Lab217MX/Cerberus-A-USB-Watchdog/Hardware/README.md

# Hardware

Recursos de hardware del proyecto Cerberus USB Watchdog.

## Contenido

### CerberusZero/

PCB principal del dispositivo Cerberus. Incluye el proyecto editable, archivos Gerber para fabricación y coordenadas para ensamblaje SMT.

- **Más información:** Ver [CerberusZero/README.md](CerberusZero/README.md)

### ADUM3160 USB Isolator/

Módulo aislador USB basado en el chip ADUM3160. Proporciona protección contra ataques USB-Killer mediante aislamiento galvánico.

- **Función:** Aísla eléctricamente el host del dispositivo USB, bloqueando picos de alto voltaje
- **Uso:** Complemento opcional para añadir una capa extra de seguridad física
- **Más información:** Ver [ADUM3160 USB Isolator/README.md](ADUM3160%20USB%20Isolator/README.md)

### Cerberus Display/

Placa de display (OLED + botones) en KiCad. Proyecto editable disponible; los Gerbers y Pick & Place aún **no se liberan** porque la placa está en validación.

- **Más información:** Ver [Cerberus Display/README.md](Cerberus%20Display/README.md)
