Lab217MX/Cerberus-A-USB-Watchdog/SCH_Schematic1_2026-06-15.pdf

# USBKiller Protection

### GPIO1

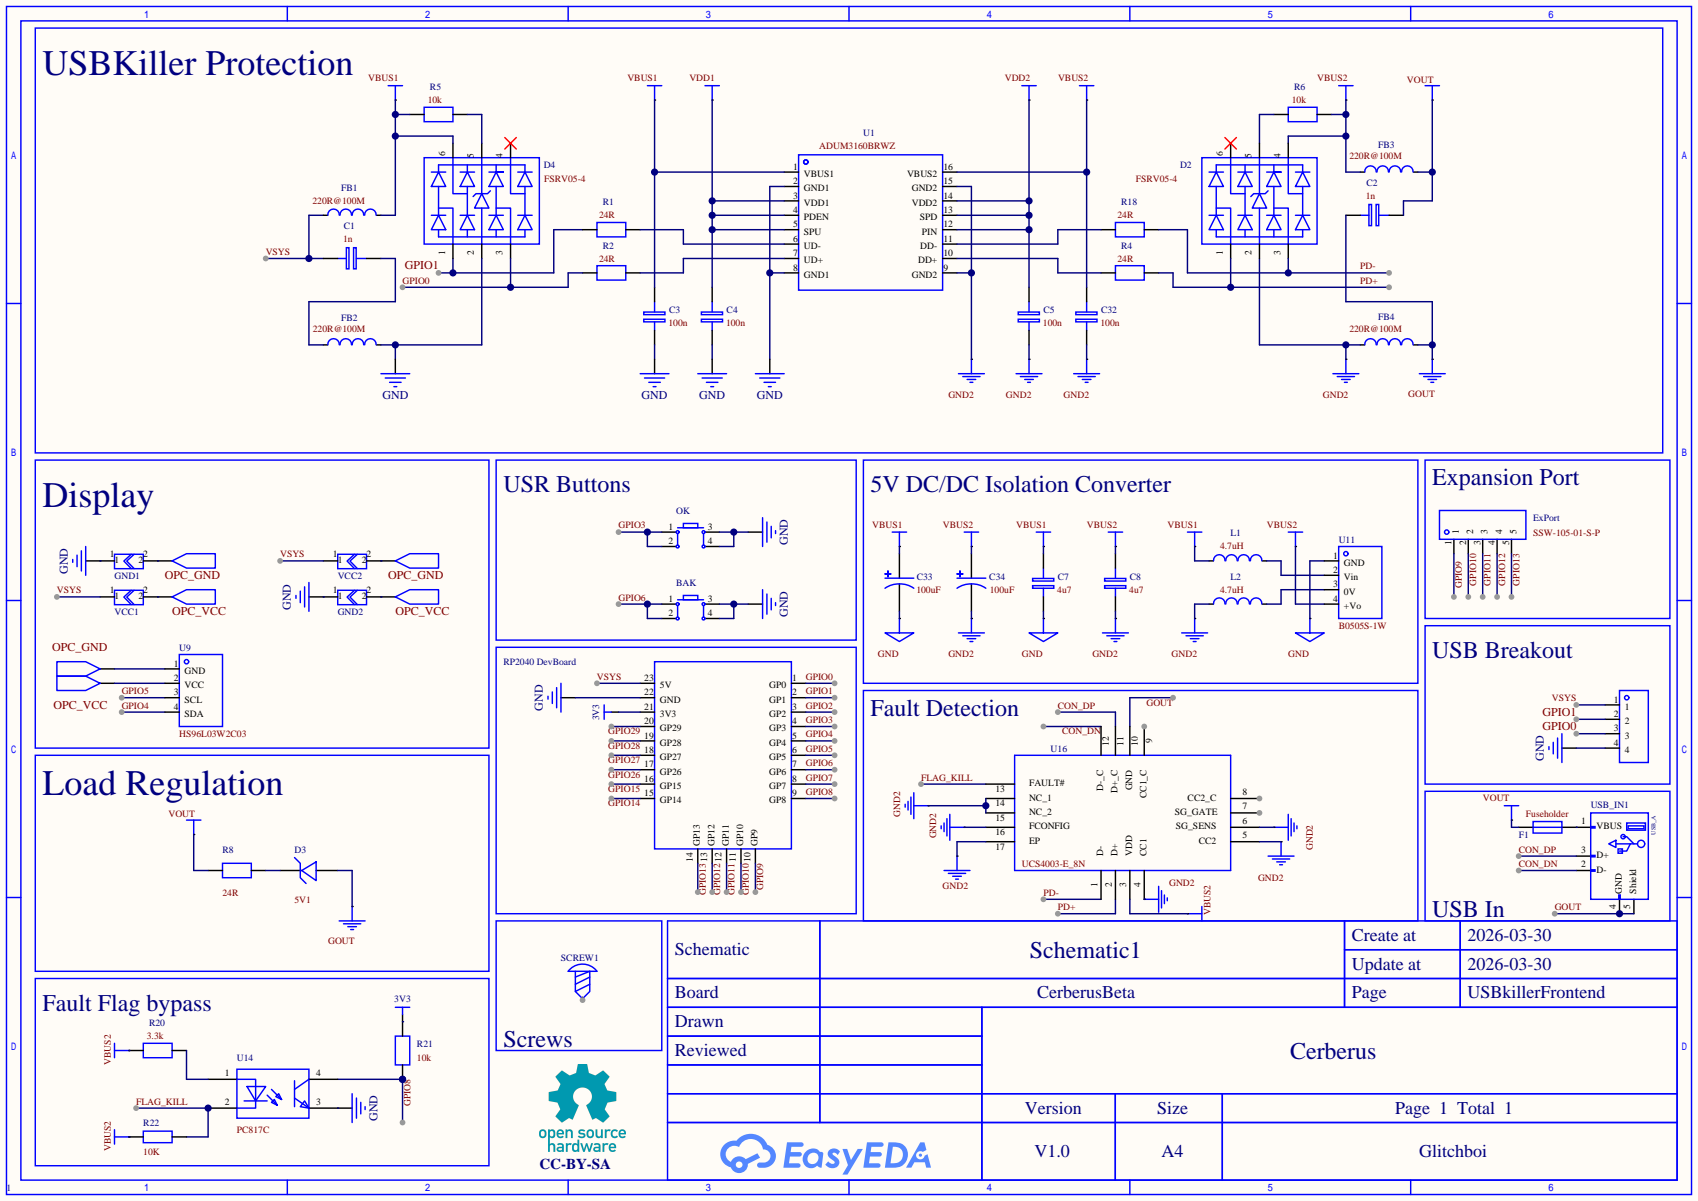
[picture p2: page 1]

5V DC/DC Isolation Converter

Schematic | Schematic1 | Create at | 2026-03-30

Update at | 2026-03-30

Board | CerberusBeta | Page | USBkillerFrontend
Drawn | | Cerberus
Reviewed

Version | Size | Page 1 Total 1

V1.0 | A4 | Glitchboi
