Lab217MX/Cerberus-A-USB-Watchdog/(list of files, drawings)

Other design files:
Hardware/CerberusZero/CerberusZero_V1.epro
