Lab217MX/Cerberus-A-USB-Watchdog/Hardware/Cerberus Display/ProPrj_Cerberus_2026-09-25.kicad_pcb

## KiCad design Hardware/Cerberus Display/ProPrj_Cerberus_2026-09-25.kicad_pcb (2026-10-14)

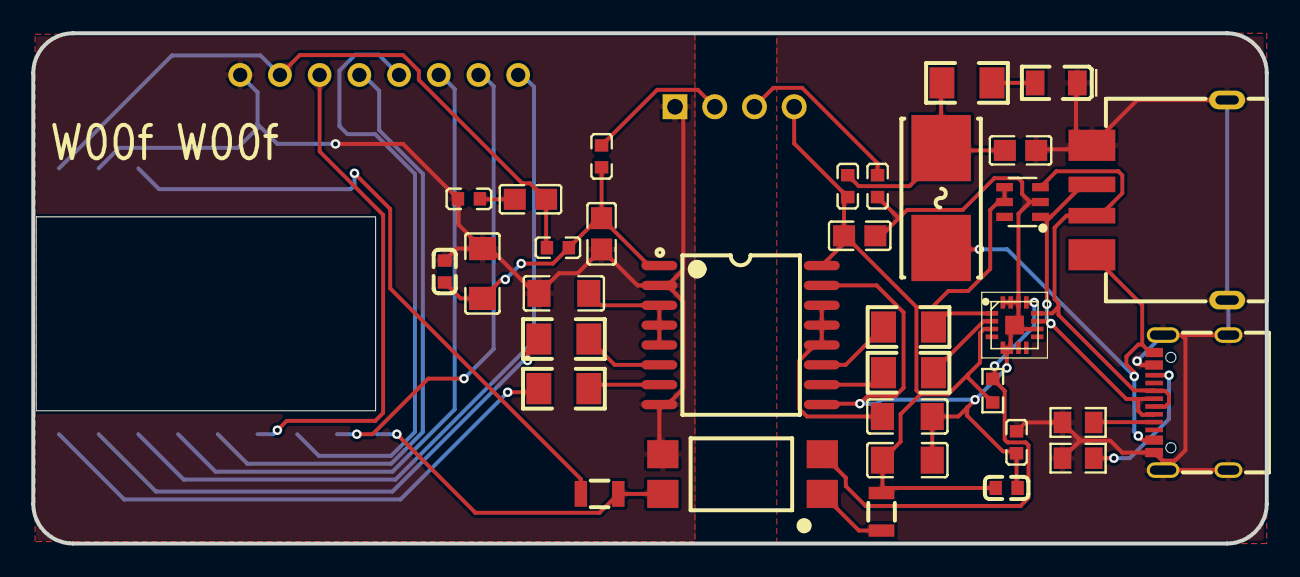
[picture p3: board ProPrj_Cerberus_2026-09-25.kicad_pcb from above]

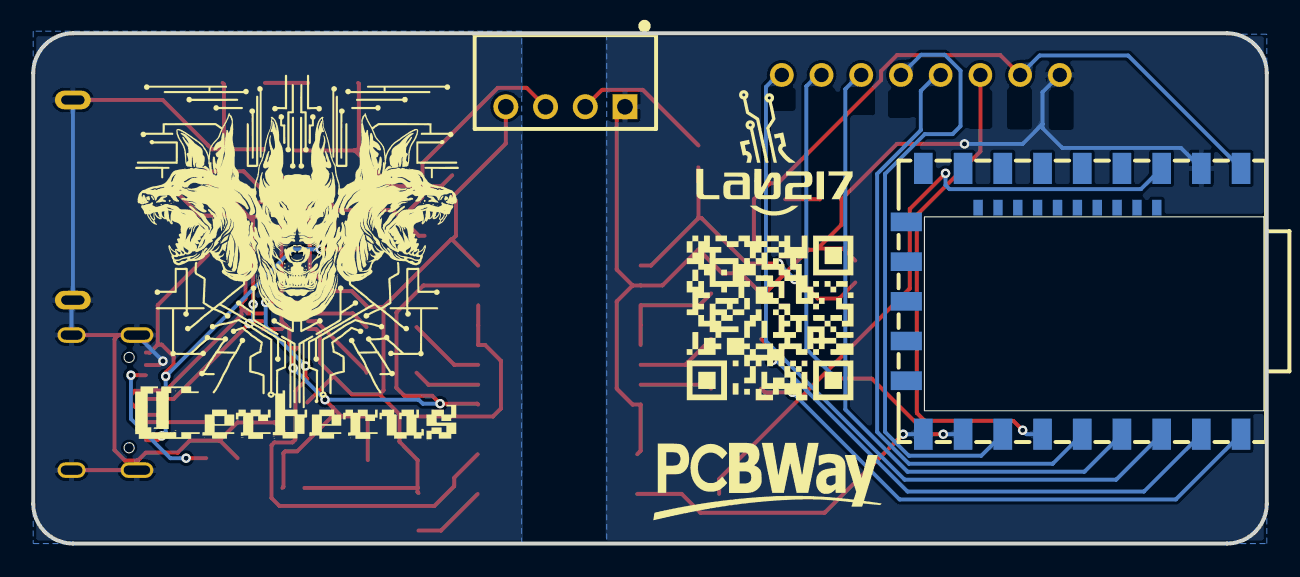
[picture p4: board ProPrj_Cerberus_2026-09-25.kicad_pcb from below]

Board: 2 copper layers, 78.9 x 32.6 mm, 37 parts (2 on the bottom side), 36 nets.

Parts:
C2, C14, C33, C34: C0805
C3, C4, C5, C32: C1206
C7, C8: C0603
D2: SOT-23-6_L2.9-W1.6-P0.95-LS2.8-BL
D3: D1206-RD_S13773
F2: FUSE-SMD_L9.7-W5.0
FB1, FB2, FB3, FB4: L0603
L1, L2: L0603
R1, R2, R4, R8, R18: R1206_1
R3, R5: R0805
R20, R21: RES-SMD_L3.2-W1.6_HCS1206FTL500
R22: R0603
U1: SOIC-16_L10.3-W7.5-P1.27-LS10.3-TL
U2: SOP-4_L6.5-W4.6-P2.54-LS10.2-TL
U4: SSD1306 128X64 4KEYS
U11: PWRM-TH_BXXXXS-1W
U15: COMM-SMD_RP2040-ZERO
U16: QFN50P300X300X100-17N
USB1: TYPE-C-SMD_LAIL-TYPE-C-16PIN-08-WT
USB2: USB-A-SMD_USB-100SD-F2

Connections:
3V3: R21.2, U15.21
$2N7232: D3.2, R8.2
$2N8019: R1.2, U1.6
$2N8020: R2.2, U1.7
$2N8021: R4.1, U1.10
$2N8022: R18.1, U1.11
$2N8501: L1.2, U11.2
$2N8502: L2.2, U11.3
$2N13465: R20.1, U2.1
$2N22688: R18.2, U16.1
$2N22689: R4.2, U16.2
$2N22702: R3.2, USB1.A5
$2N22703: R5.2, USB1.B5
$2N22723: C14.1, FB2.2
CON_DN: D2.1, U16.11, USB1.A7, USB1.B7, USB2.3
CON_DP: D2.3, U16.12, USB1.A6, USB1.B6, USB2.2
FLAG_KILL: R22.1, U2.2, U16.13
GND: C3.1, C4.1, C7.1, C33.2, FB2.1, U1.2, U1.8, U2.3, U4.1, U11.1, U15.22
GND2: C5.1, C8.1, C32.1, C34.2, D2.2, FB4.1, L2.1, U1.9, U1.15, U16.5, U16.6, U16.10, U16.14, U16.15, U16.16, U16.17
GOUT: C2.1, D3.1, FB4.2, R3.1, R5.1, USB1.13, USB1.14, USB1.15, USB1.16, USB1.A1B12, USB1.B4A9, USB2.4, USB2.5, USB2.6
GPIO0: R2.1, U15.1
GPIO1: R1.1, U15.2
GPIO2: U4.8, U15.3
GPIO3: U4.6, U15.4
GPIO4: U4.4, U15.5
GPIO5: U4.3, U15.6
GPIO6: U4.5, U15.7
GPIO7: U4.7, U15.8
GPIO8: R21.1, U2.4, U15.9
VBUS1: C3.2, C7.2, C33.1, FB1.2, L1.1, U1.1
VBUS2: C8.2, C32.2, C34.1, D2.4, D2.5, FB3.1, R20.2, R22.2, U1.16, U11.4, U16.3
VDD1: C4.2, U1.3, U1.4, U1.5
VDD2: C5.2, U1.12, U1.13, U1.14
VOUT: C2.2, F2.1, FB3.2, R8.1
VSYS: C14.2, FB1.1, U4.2, U15.23
V_FUSE: F2.2, USB1.A4B9, USB1.B1A12, USB2.1
