Lab217MX/Cerberus-A-USB-Watchdog/Software/Cerberus/resources.h

#pragma once

#include <stddef.h>
#include <stdint.h>

// Footer icons (small)
static const unsigned char PROGMEM image_arrow_curved_left_up_bits[] = {0xf0,0xe0,0xf1,0xbe,0x18};
static const unsigned char PROGMEM image_Lock_bits[] = {0x38,0x44,0x44,0xfe,0xfe,0xee,0xfe,0x7c};
static const unsigned char PROGMEM image_Quest_bits[] = {0x78,0xcc,0xcc,0x0c,0x18,0x30,0x00,0x30};

// Main logos - USB cable connected (16x16 = 32 bytes)
static const unsigned char PROGMEM image_usb_cable_connected_bits[] = {
  0x00,0x00,0x00,0x00,0x00,0x00,0x00,0xc0,
  0x03,0xe0,0x04,0xc0,0x08,0x04,0xc8,0x06,
  0xff,0xff,0xc2,0x06,0x02,0x04,0x01,0x30,
  0x00,0xf8,0x00,0x30,0x00,0x00,0x00,0x00
};

// Alert triangle (16x16 = 32 bytes)
static const unsigned char PROGMEM image_Alert_bits[] = {
  0x00,0x00,0x01,0x80,0x02,0x40,0x02,0x40,
  0x04,0x20,0x09,0x90,0x09,0x90,0x11,0x88,
  0x11,0x88,0x21,0x84,0x40,0x02,0x41,0x82,
  0x81,0x81,0x80,0x01,0x7f,0xfe,0x00,0x00
};

// Evil smile / skull (24x21 = 63 bytes)
static const unsigned char PROGMEM image_EviSmile1_bits[] = {
  0x30,0x03,0x00,0x60,0x01,0x80,0xe0,0x01,0xc0,
  0xf3,0xf3,0xc0,0xff,0xff,0xc0,0xff,0xff,0xc0,
  0x7f,0xff,0x80,0x7f,0xff,0x80,0x7f,0xff,0x80,
  0xef,0xfd,0xc0,0xe7,0xf9,0xc0,0xe3,0xf1,0xc0,
  0xe1,0xe1,0xc0,0xf1,0xe3,0xc0,0xff,0xff,0xc0,
  0x7f,0xff,0x80,0x7b,0xf7,0x80,0x3d,0x2f,0x00,
  0x1e,0x1e,0x00,0x0f,0xfc,0x00,0x03,0xf0,0x00
};

typedef struct {
  const unsigned char* bits;
  uint8_t width;
  uint8_t height;
} LogoAsset;

static const LogoAsset LOGO_ASSETS[] = {
  { image_usb_cable_connected_bits, 16, 16 },  // USB cable
  { image_Alert_bits, 16, 16 },                // Alert triangle
  { image_EviSmile1_bits, 24, 21 },            // Evil smile
};

static constexpr size_t LOGO_COUNT = sizeof(LOGO_ASSETS) / sizeof(LOGO_ASSETS[0]);

enum LogoId : uint8_t {
  LOGO_USB_CONNECTED = 0,
  LOGO_ALERT_SYMBOL = 1,
  LOGO_EVIL_SYMBOL = 2,
};
