Lab217MX/Cerberus-A-USB-Watchdog/Software/Cerberus/GUI_Base.h

/*
  Cerberus - GUI_Base.h

  The whole on-device GUI in one place: every screen as a small, parameterized
  draw function plus the (shared, de-duplicated) 1-bit artwork it needs. Lopaka
  exported each screen as an isolated snippet with hard-coded demo text and very
  long image names; this header is the cleaned-up, integratable version:

    - one include of the fonts, one copy of each bitmap (short, friendly names),
    - every screen is a function that takes the real data to display,
    - a shared footer helper (Ok / Bak soft-keys) instead of repeating it.

  Rendering targets the global `display` (Adafruit_SSD1306, 128x64) declared in
  Cerberus.ino, so this header must be included after `display`. Colour 1 = white
  (lit pixel), 0 = black, matching SSD1306_WHITE / SSD1306_BLACK.
*/

#pragma once

#include "Petme8x8.h"     // title / label font
#include "Picopixel.h"    // tiny footer / detail font

// ---------------------------------------------------------------------------
// Artwork (each defined once; friendly names replace the lopaka export names)
// ---------------------------------------------------------------------------
// Footer soft-key glyphs (7x7)
static const unsigned char PROGMEM img_ok[]  = {0x14,0x14,0x7e,0x28,0xfc,0x50,0x50};   // was image_ok_sym_bits
static const unsigned char PROGMEM img_bak[] = {0x92,0x54,0x38,0xfe,0x38,0x54,0x92};   // was image_bak_sym_bits

// Mass-storage menu row icons
static const unsigned char PROGMEM img_quest[] = {0x78,0xcc,0xcc,0x0c,0x18,0x30,0x00,0x30};                      // 7x8  (Info)
static const unsigned char PROGMEM img_sd[]    = {0xff,0xe0,0xff,0x20,0xff,0xe0,0xff,0x20,0xff,0xe0,0xff,0x20,0xff,0xe0,0xe6,0x00}; // 11x8 (Files)
static const unsigned char PROGMEM img_alert[] = {0x08,0x00,0x1c,0x00,0x14,0x00,0x36,0x00,0x36,0x00,0x7f,0x00,0x77,0x00,0xff,0x80}; // 9x8  (Wipe)

// Small status glyphs
static const unsigned char PROGMEM img_help[]   = {0x00,0x00,0x0f,0x00,0x30,0xc0,0x46,0x20,0x4f,0x20,0x89,0x10,0x83,0x10,0x86,0x10,0x86,0x10,0x40,0x20,0x46,0x20,0x30,0xc0,0x0f,0x00,0x00,0x00,0x00,0x00,0x00,0x00}; // 12x16 (Info pages)
static const unsigned char PROGMEM img_hidden[] = {0x7f,0x80,0x7e,0x80,0x7f,0x80,0x40,0x80,0xfe,0x80,0x82,0x80,0x83,0x80,0xfe,0x00}; // 9x8  (file list header)

// Open folder (21x21): shown when there is no device to open a menu for
static const unsigned char PROGMEM img_folder[] = {0x0f,0xff,0xc0,0x08,0x00,0xe0,0x08,0x00,0xf0,0x08,0x00,0xf8,0x08,0x00,0xf8,0x08,0x44,0x08,0x08,0x00,0x08,0x08,0x38,0x08,0x7c,0x00,0x08,0x82,0x00,0x08,0x81,0xff,0x88,0x80,0x00,0x48,0x40,0x00,0x48,0x40,0x00,0x28,0x20,0x00,0x28,0x20,0x00,0x18,0x10,0x00,0x18,0x10,0x00,0x08,0x08,0x00,0x08,0x08,0x00,0x08,0x07,0xff,0xf0};

// USB flash drive (21x21): shown on the mass-storage detection screen
static const unsigned char PROGMEM img_flashdrive[] = {0x01,0xfc,0x00,0x02,0x02,0x00,0x02,0xfa,0x00,0x02,0x02,0x00,0x02,0x02,0x00,0x07,0xff,0x00,0x04,0x01,0x00,0x04,0x21,0x00,0x04,0x21,0x00,0x05,0x21,0x00,0x05,0x25,0x00,0x05,0x25,0x00,0x04,0xa9,0x00,0x04,0x71,0x00,0x04,0x71,0x00,0x04,0x71,0x00,0x04,0x01,0x00,0x04,0x01,0x00,0x04,0x01,0x00,0x02,0x02,0x00,0x01,0xfc,0x00};

// Large illustrations (21x21 unless noted)
static const unsigned char PROGMEM img_hand_ok[]  = {0x05,0x80,0x00,0x0a,0x40,0x00,0x0a,0x40,0x00,0x1a,0x40,0x00,0x2a,0x40,0x00,0x2a,0x4f,0x00,0x2a,0x50,0x80,0x2a,0x60,0x40,0x28,0x46,0x20,0x22,0x89,0x20,0x2a,0x90,0xc0,0x28,0x11,0x20,0x20,0x11,0x20,0x20,0x0e,0x20,0x20,0x00,0x40,0x10,0x00,0x40,0x10,0x00,0x80,0x08,0x01,0x00,0x1f,0xff,0x80,0x1f,0xf9,0x80,0x1f,0xff,0x80}; // home: self-test ok
static const unsigned char PROGMEM img_skull[]    = {0x60,0x00,0x60,0xe0,0x00,0x70,0xf0,0x00,0xf0,0x39,0xf9,0xc0,0x1e,0x07,0x80,0x08,0x01,0x00,0x08,0x01,0x00,0x13,0x0c,0x80,0x17,0x9e,0x80,0x27,0x9e,0x40,0x23,0x0c,0x40,0x20,0x00,0x40,0x20,0x60,0x40,0x10,0x00,0x80,0x08,0x01,0x00,0x1c,0x03,0x80,0x3c,0x93,0xc0,0xf4,0x92,0xf0,0xe3,0xfc,0x70,0x60,0x00,0x60,0x00,0x00,0x00}; // USB killer
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

// 18x21 evil grin
static const unsigned char PROGMEM img_evil[] = {0x00,0x00,0x00,0x70,0x03,0x80,0xe0,0x01,0xc0,0xf3,0xf3,0xc0,0xff,0xff,0xc0,0xff,0xff,0xc0,0x7f,0xff,0x80,0x7f,0xff,0x80,0x7f,0xff,0x80,0xe7,0xf9,0xc0,0xe3,0xf1,0xc0,0xe1,0xe1,0xc0,0xf1,0xe3,0xc0,0xff,0xff,0xc0,0xff,0xff,0xc0,0x73,0x33,0x80,0x79,0x27,0x80,0x3c,0x0f,0x00,0x1f,0xfe,0x00,0x0f,0xfc,0x00,0x03,0xf0,0x00}; // HID auto-typing

// ---------------------------------------------------------------------------
// Shared bits
// ---------------------------------------------------------------------------
// Ok / Bak soft-key hints, bottom-right. Every screen shows these.
static void guiFooter() {
  display.drawBitmap(76, 56, img_ok, 7, 7, SSD1306_WHITE);
  display.drawBitmap(101, 56, img_bak, 7, 7, SSD1306_WHITE);
  display.setFont(&Picopixel);
  display.setCursor(86, 61);  display.print("Ok");
  display.setCursor(111, 61); display.print("Bak");
}

// Call once at the top of every screen.
static void guiBegin() {
  display.clearDisplay();
  display.setTextColor(SSD1306_WHITE);
  display.setTextWrap(false);
}

// "By: Lab217" branding line (Picopixel), bottom-left. Call after guiFooter().
static void guiByline() {
  display.setFont(&Picopixel);
  display.setCursor(2, 61);
  display.print("By: Lab217");
}

// ---------------------------------------------------------------------------
// Screens
// ---------------------------------------------------------------------------

// Idle / home. `selfTest` is the real power-on self-test line, e.g.
// "Self-Test:ok" or "Self-Test:FAIL".
void guiMainMenu(const char* selfTest) {
  guiBegin();
  display.setFont(&Petme8x8);
  display.setCursor(0, 11);  display.print("Cerberus");
  display.drawBitmap(3, 24, img_hand_ok, 21, 21, SSD1306_WHITE);
  display.setCursor(26, 40); display.print(selfTest);
  guiFooter();                                   // Picopixel from here on
  display.setCursor(2, 61);  display.print("By: Lab217");
  display.setFont();
  display.display();
}

// Mass-storage DETECTION screen: a device was just attached. Distinct from the
// options menu -- any button except Bak opens the menu (handled by the caller).
void guiMassDetect() {
  guiBegin();
  display.setFont(&Petme8x8);
  display.setCursor(0, 11);  display.print("Cerberus");
  display.setCursor(29, 36); display.print("Mass storage");
  display.drawBitmap(2, 21, img_flashdrive, 21, 21, SSD1306_WHITE);
  guiFooter();
  display.setFont();
  display.display();
}

// Mass-storage options menu. `sel`: 0=Info, 1=Files, 2=Wipe (highlighted row is
// drawn inverted so the current selection is obvious).
void guiMassMenu(int sel) {
  static const struct { const char* label; int textY; const unsigned char* icon; int iconX, iconY, iconW; }
  ROWS[3] = {
    { "Info",  26, img_quest, 46, 18, 7  },
    { "Files", 40, img_sd,    44, 32, 11 },
    { "Wipe",  54, img_alert, 46, 46, 9  },
  };
  static const int BOX_Y[3] = { 17, 31, 45 };    // inverted-bar top per row

  guiBegin();
  display.setFont(&Petme8x8);
  display.setCursor(0, 11); display.print("Options");

  for (int i = 0; i < 3; i++) {
    uint16_t fg = SSD1306_WHITE;
    if (i == sel) {
      display.fillRect(0, BOX_Y[i], 60, 11, SSD1306_WHITE);
      fg = SSD1306_BLACK;
    }
    display.setTextColor(fg);
    display.setCursor(2, ROWS[i].textY); display.print(ROWS[i].label);
    display.drawBitmap(ROWS[i].iconX, ROWS[i].iconY, ROWS[i].icon, ROWS[i].iconW, 8, fg);
  }
  display.setTextColor(SSD1306_WHITE);

  display.drawBitmap(76, 13, img_bug, 42, 42, SSD1306_WHITE);
  guiFooter();
  display.setFont();
  display.display();
}

// Tried to open a menu but nothing is plugged into the host port. Any button
// returns to the home screen (handled by the caller).
void guiNoDevice() {
  guiBegin();
  display.setFont(&Petme8x8);
  display.setCursor(0, 11);  display.print("Cerberus");
  display.setCursor(39, 37); display.print("No device");
  display.drawBitmap(7, 24, img_folder, 21, 21, SSD1306_WHITE);
  guiFooter();
  display.setFont();
  display.display();
}

// USB-killer (hostile voltage) detected.
void guiBadUsb() {
  guiBegin();
  display.setFont(&Petme8x8);
  display.setCursor(0, 11);  display.print("Cerberus");
  display.setCursor(42, 39); display.print("USBKiller");
  display.drawBitmap(6, 25, img_skull, 21, 21, SSD1306_WHITE);
  guiFooter();
  display.setFont();
  display.display();
}

// Device descriptor page. `title` e.g. "Desc [1/3]"; `fields` holds up to 7
// short "Key:Val" strings laid out in a two-column grid (the layout adapts to
// however many are supplied, so pages with fewer fields stay clean).
void guiDescPage(const char* title, const char* const* fields, int nFields) {
  static const struct { int x, y; } SLOT[7] = {
    {1,15},{59,15}, {1,26},{59,27}, {1,36},{59,37}, {1,46},
  };
  guiBegin();
  display.setFont(&Petme8x8);
  display.setCursor(0, 11); display.print(title);
  display.drawBitmap(86, 0, img_help, 12, 16, SSD1306_WHITE);
  guiFooter();

  display.setFont();                             // built-in 5x7 for the fields
  if (nFields > 7) nFields = 7;
  for (int i = 0; i < nFields; i++) {
    if (!fields[i]) continue;
    display.setCursor(SLOT[i].x, SLOT[i].y);
    display.print(fields[i]);
  }
  display.display();
}

// File analyzer list. Pulls each visible row's text through callbacks so the
// caller needn't build arrays: nameOf/typeOf return the file name and its
// magic-byte type for a global index. `count` total files, window at `top`,
// `sel` highlighted. Up to 4 rows are shown with a scrollbar.
#define GUI_FILELIST_VIS 3                       // rows shown at once (keep clear of footer)
typedef const char* (*GuiRowTextFn)(int idx, void* ctx);
void guiFileList(int count, int top, int sel,
                 GuiRowTextFn nameOf, GuiRowTextFn typeOf, void* ctx) {
  const int VIS = GUI_FILELIST_VIS;
  const int ROWY[VIS] = { 19, 31, 43 };          // classic-font top-left y per row

  guiBegin();
  display.setFont(&Petme8x8);
  display.setCursor(0, 11); display.print("Files");
  display.drawBitmap(45, 3, img_hidden, 9, 8, SSD1306_WHITE);
  guiFooter();

  display.setFont();                             // built-in 5x7 for the rows
  if (count == 0) {
    display.setCursor(1, 28); display.print("(no files found)");
  }
  for (int r = 0; r < VIS && (top + r) < count; r++) {
    int idx = top + r;
    int y   = ROWY[r];
    // Classic font draws DOWN from y, so the highlight bar spans y-1 .. y+7 and
    // is wide enough to cover both the name and the type (type sat outside the
    // old 100px bar, which is why it vanished when selected).
    if (idx == sel) {
      display.fillRect(0, y - 1, 121, 9, SSD1306_WHITE);
      display.setTextColor(SSD1306_BLACK);
    }
    char nm[14]; snprintf(nm, sizeof(nm), "%.13s", nameOf ? nameOf(idx, ctx) : "?");
    display.setCursor(1, y);  display.print(nm);
    char tp[7];  snprintf(tp, sizeof(tp), "%.6s", typeOf ? typeOf(idx, ctx) : "");
    display.setCursor(84, y); display.print(tp);
    display.setTextColor(SSD1306_WHITE);
  }
  if (count > VIS) {                             // scrollbar, clear of the row bars
    int barH = 36 * VIS / count; if (barH < 4) barH = 4;
    int barY = 16 + (36 - barH) * top / (count - VIS);
    display.drawFastVLine(124, 16, 36, SSD1306_WHITE);
    display.fillRect(123, barY, 3, barH, SSD1306_WHITE);
  }
  display.display();
}

// Hex / magic-byte viewer. `fname` already truncated for the title; `type` the
// detected file type (e.g. "PNG image"); `info` a short status line (e.g.
// "145B HEX"); `rows` up to 3 pre-formatted hex lines ("000: 43 65 72 ...").
void guiHexView(const char* fname, const char* type, const char* info,
                const char* const* rows, int nRows) {
  guiBegin();
  display.setFont(&Petme8x8);
  display.setCursor(0, 11);
  char title[22]; snprintf(title, sizeof(title), "Hex: %.14s", fname ? fname : "");
  display.print(title);
  display.drawBitmap(93, 24, img_file_bug, 21, 21, SSD1306_WHITE);
  guiFooter();

  display.setFont();
  display.setCursor(1, 15);
  char tbuf[20]; snprintf(tbuf, sizeof(tbuf), "Type: %.13s", type ? type : "?");
  display.print(tbuf);

  display.setFont(&Picopixel);
  display.setCursor(1, 30); display.print(info ? info : "");
  if (nRows > 3) nRows = 3;
  const int ROWY[3] = { 38, 45, 52 };
  for (int i = 0; i < nRows; i++) {
    if (!rows[i]) continue;
    display.setCursor(1, ROWY[i]); display.print(rows[i]);
  }
  display.setFont();
  display.display();
}

// GPT/partition-table wipe confirmation. UX: Ok wipes (destructive), Bak
// cancels -- no on-screen Yes/No toggle; the soft-keys ARE the choice.
void guiWipe() {
  guiBegin();
  display.setFont(&Petme8x8);
  display.setCursor(0, 11); display.print("Wipe Device");
  display.drawBitmap(13, 30, img_alert_tri, 21, 21, SSD1306_WHITE);
  guiFooter();

  display.setFont();
  display.setCursor(7, 19);  display.print("Destroy GPT tables?");
  display.setCursor(55, 32); display.print("This is");
  display.setCursor(46, 41); display.print("Irreversible");
  display.display();
}

// Power-on self-test failed -- the device halts after this.
void guiBadSelftest() {
  guiBegin();
  display.setFont(&Petme8x8);
  display.setCursor(0, 11);  display.print("Cerberus");
  display.setCursor(27, 31); display.print("Self-Test:ko");
  display.drawBitmap(3, 24, img_finger, 21, 21, SSD1306_WHITE);
  display.setFont();
  display.setCursor(40, 44); display.print("Stopping...");
  guiFooter();
  guiByline();
  display.setFont();
  display.display();
}

// Rebooting (REBOOT command).
void guiReboot() {
  guiBegin();
  display.setFont(&Petme8x8);
  display.setCursor(0, 11);  display.print("Cerberus");
  display.setCursor(51, 39); display.print("Reboot");
  display.drawBitmap(19, 24, img_refresh, 21, 21, SSD1306_WHITE);
  guiFooter();
  guiByline();
  display.setFont();
  display.display();
}

// Resetting (BOOTSEL short press).
void guiResetting() {
  guiBegin();
  display.setFont(&Petme8x8);
  display.setCursor(0, 11);  display.print("Cerberus");
  display.setCursor(40, 37); display.print("Resetting");
  display.drawBitmap(8, 23, img_stat, 21, 21, SSD1306_WHITE);
  guiFooter();
  guiByline();
  display.setFont();
  display.display();
}

// HID event count (BOOTSEL long press). `count` = events seen so far.
void guiHidEvents(int count) {
  guiBegin();
  display.setFont(&Petme8x8);
  display.setCursor(0, 11);  display.print("Cerberus");
  display.setCursor(40, 30); display.print("HID Events");
  display.drawBitmap(7, 22, img_graph, 21, 21, SSD1306_WHITE);
  display.setFont();
  char buf[12]; snprintf(buf, sizeof(buf), "#%d", count);
  display.setCursor(65, 34); display.print(buf);
  guiFooter();
  guiByline();
  display.setFont();
  display.display();
}

// Generic status line coming from the host-callback queue. `msg` is free text.
void guiGenericMsg(const char* msg) {
  guiBegin();
  display.setFont(&Petme8x8);
  display.setCursor(0, 11);  display.print("Cerberus");
  display.drawBitmap(8, 23, img_note, 21, 21, SSD1306_WHITE);
  display.setFont();
  display.setCursor(34, 34); display.print(msg ? msg : "");
  guiFooter();
  guiByline();
  display.setFont();
  display.display();
}

// The host read the bait README file.
void guiReadmeRead() {
  guiBegin();
  display.setFont(&Petme8x8);
  display.setCursor(0, 11);  display.print("Cerberus");
  display.setCursor(63, 26); display.print("Read");
  display.setCursor(57, 41); display.print("README");
  display.drawBitmap(11, 23, img_alert_circle, 21, 21, SSD1306_WHITE);
  guiFooter();
  display.setFont();
  display.display();
}

// The host read the bait AUTORUN.INF file.
void guiAutorunRead() {
  guiBegin();
  display.setFont(&Petme8x8);
  display.setCursor(0, 11);  display.print("Cerberus");
  display.setCursor(59, 30); display.print("Read");
  display.setCursor(49, 41); display.print("AutoRun");
  display.drawBitmap(11, 23, img_alert_circle, 21, 21, SSD1306_WHITE);
  guiFooter();
  display.setFont();
  display.display();
}

// The host wrote to the emulated disk.
void guiWriting() {
  guiBegin();
  display.setFont(&Petme8x8);
  display.setCursor(0, 11);  display.print("Cerberus");
  display.setCursor(51, 31); display.print("Writing");
  display.setCursor(47, 41); display.print("Emulated");
  display.drawBitmap(12, 23, img_skull1, 21, 21, SSD1306_WHITE);
  guiFooter();
  display.setFont();
  display.display();
}

// The host deleted on the emulated disk.
void guiDeleting() {
  guiBegin();
  display.setFont(&Petme8x8);
  display.setCursor(0, 11);  display.print("Cerberus");
  display.setCursor(47, 31); display.print("Deleting");
  display.setCursor(47, 41); display.print("Emulated");
  display.drawBitmap(12, 23, img_skull1, 21, 21, SSD1306_WHITE);
  guiFooter();
  display.setFont();
  display.display();
}

// A HID device was attached (mount notice). `name` = product string / "unknown".
void guiHidMount(const char* name) {
  guiBegin();
  display.setFont(&Petme8x8);
  display.setCursor(0, 11);  display.print("Cerberus");
  display.setCursor(34, 22); display.print("HID Device");
  display.drawBitmap(4, 26, img_keyboard, 21, 21, SSD1306_WHITE);
  display.setFont();
  display.setCursor(34, 34); display.print(name && name[0] ? name : "unknown");
  guiFooter();
  display.setFont();
  display.display();
}

// A HID device is sending data / typing automatically (BadUSB). `name` + speed.
void guiHidSendData(const char* name, float kps) {
  guiBegin();
  display.setFont(&Petme8x8);
  display.setCursor(0, 11);  display.print("Cerberus");
  display.setCursor(48, 31); display.print("HID Data");
  display.drawBitmap(8, 25, img_evil, 18, 21, SSD1306_WHITE);
  display.setFont();
  display.setCursor(48, 33); display.print(name && name[0] ? name : "unknown");
  display.setFont(&Picopixel);
  char buf[18]; snprintf(buf, sizeof(buf), "Auto %.0f k/s", (double)kps);
  display.setCursor(60, 48); display.print(buf);
  guiFooter();
  display.setFont();
  display.display();
}

// A CDC (serial) device was attached. `name` = product string / "unknown".
void guiCdcDevice(const char* name) {
  guiBegin();
  display.setFont(&Petme8x8);
  display.setCursor(0, 11);  display.print("Cerberus");
  display.setCursor(34, 22); display.print("CDC Device");
  display.drawBitmap(8, 21, img_upload, 21, 21, SSD1306_WHITE);
  display.setFont();
  display.setCursor(34, 34); display.print(name && name[0] ? name : "unknown");
  guiFooter();
  display.setFont();
  display.display();
}

// Partition-table wipe in progress.
void guiWipingProgress() {
  guiBegin();
  display.setFont(&Petme8x8);
  display.setCursor(0, 11);  display.print("Wipe Device");
  display.drawBitmap(11, 23, img_link_broken, 21, 21, SSD1306_WHITE);
  display.setFont();
  display.setCursor(43, 29); display.print("Wiping Disk");
  guiFooter();
  display.setFont();
  display.display();
}

// Partition-table wipe finished OK.
void guiWipingDone() {
  guiBegin();
  display.setFont(&Petme8x8);
  display.setCursor(0, 11);  display.print("Wipe Device");
  display.drawBitmap(12, 23, img_lock, 21, 21, SSD1306_WHITE);
  display.setFont();
  display.setCursor(43, 29); display.print("Wiping Done");
  guiFooter();
  display.setFont();
  display.display();
}

// Partition-table wipe failed.
void guiWipingError() {
  guiBegin();
  display.setFont(&Petme8x8);
  display.setCursor(0, 11);  display.print("Wipe Device");
  display.drawBitmap(9, 24, img_zombie, 21, 21, SSD1306_WHITE);
  display.setFont();
  display.setCursor(44, 30); display.print("Wiping Error");
  guiFooter();
  display.setFont();
  display.display();
}
