Lab217MX/Cerberus-A-USB-Watchdog/(commit log)

2026-04-16 Upload: Gerger incluido
    [CerberusZero_V1.epro, PickAndPlace_CerberusZero.csv]
2026-06-04 Update README.md
    Cambio de propietario
2026-09-24 Add USB content explorer (inspect a drive before trusting it on the PC)
    Mount a mass-storage device plugged into the HOST port read-only and
    inspect its FAT16/32/exFAT contents before it ever reaches the real PC.
    - Ported the storage explorer from the rp2350_knife project
    (Adafruit_USBH_MSC_BlockDevice + SdFat FsVolume) into a new
    usb_explorer.ino, running FAT ops on core1 via the existing
    core0->core1 request pattern (mscService in loop1).
    - Merged the FS mount/unmount into the existing tuh_msc callbacks,
    keeping the partition-wipe bookkeeping intact.
    - Two frontends: serial commands LS / CAT / BROWSE, and an on-device
    OLED browser (hold OK to open; short OK = scroll, hold OK = s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
2026-10-14 Add on-device file analyzer, redesign OLED GUI, drop companion app
    Firmware (v2.0):
    - File analyzer: recursive read-only multi-FS (FAT/exFAT/NTFS/ext/ISO9660)
    listing that types each file by magic bytes and flags extension/type
    mismatches, executables inside ZIP archives (central-directory parse), and
    signatures appended after a valid header (polyglots). Signature-only, nothing
    is decompressed, so it is zip-bomb-safe.
    - Serial: new SCAN and INSPECT commands; VERBOSE defaults off (per-sector LBA
    log flooded the console); banner on terminal connect; CRLF line endings.
    - OLED: new GUI_Base.h screen library (home, mass-storage detection, options
    menu, descriptors, file list, hex view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
2026-10-15 Add dedicated OLED screens for all status events; drop legacy renderer
    - GUI_Base.h: adapt and include the remaining status/alert screens
    (self-test fail, reboot, resetting, HID event count, generic message,
    README/AUTORUN read, writing/deleting, HID mount, HID auto-typing, CDC
    device, wipe in-progress/done/error) with de-duplicated artwork and
    friendly names.
    - Wire every event to its screen. HID/CDC attach notices raise a core1->core0
    flag so the OLED (I2C) is only driven from core 0 (no cross-core race).
    - Remove the legacy draw()/showStatus logo renderer and resources.h: boot
    splash -> guiMainMenu, redraw fallback / showStatus -> guiGenericMsg.
    GUI_Base.h is now the single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
