Lab217MX/Cerberus-A-USB-Watchdog/(notices)

Notices in the files:
Hardware/Cerberus Display/ProPrj_Cerberus_2026-09-25.kicad_sch:
CC-BY-SA
